clement-jin/curtain-alarm/(commit log)

2023-01-07 integrated buzzer and motor
    [alarm.cpp]
2023-03-30 fixed 'motor not running' issue
    [alarm.cpp]
2023-03-30 reset variables to working mode
    [UI.cpp, alarm.cpp, clock.cpp]
2023-03-30 increments clock after alarm goes off. Fixed time types from int to long. Now compatible with minutes
    [UI.cpp, alarm.cpp, clock.cpp]
2025-09-28 Uploaded supporting material
2025-09-28 Rename Arkwright Presentation v_1.pptx to supporting-material/Arkwright Presentation.pptx
2025-09-28 Rename Motor Alarm Design.pdf to supporting-material/Motor Alarm Design.pdf
